cxxx1828/ROS1-Robot-Car-and-Robot-Arm/HW/Proto_Servo_Current_Limiter_Shield/Proto_Servo_Current_Limiter_Shield.kicad_pcb

## KiCad design HW/Proto_Servo_Current_Limiter_Shield/Proto_Servo_Current_Limiter_Shield.kicad_pcb (2025-11-28)

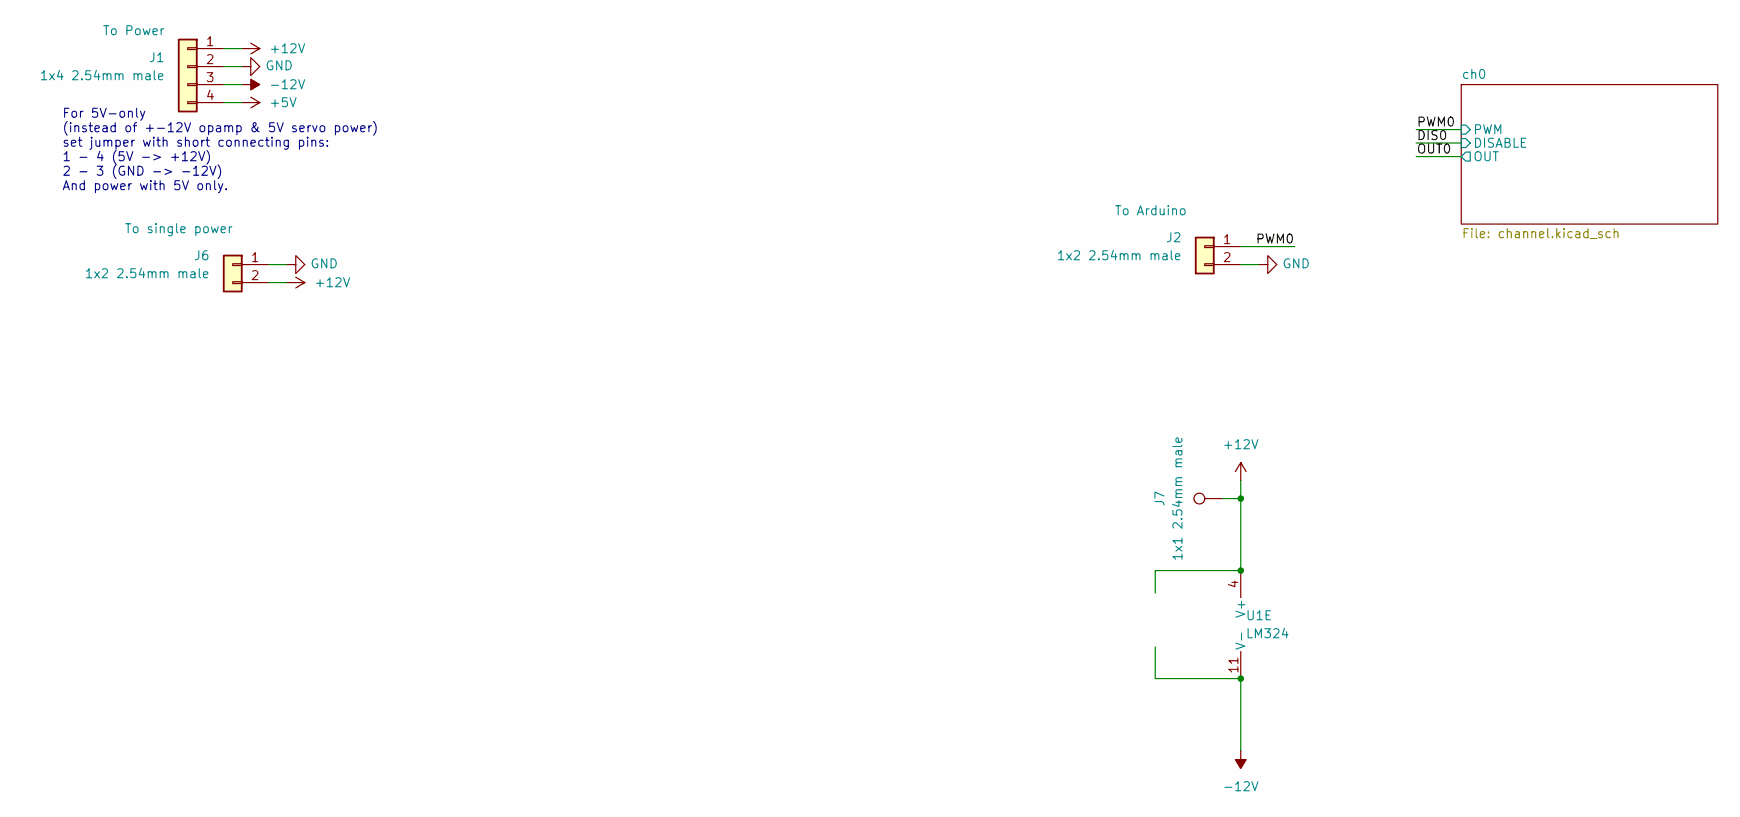
[picture p1: schematic Proto_Servo_Current_Limiter_Shield.kicad_sch]

Parts:
J1: 1x4 2.54mm male; PinHeader_1x04_P2.54mm_Vertical
J2, J6: 1x2 2.54mm male; PinHeader_1x02_P2.54mm_Vertical
J7: 1x1 2.54mm male; PinHeader_1x01_P2.54mm_Vertical
U1: LM324; DIP-14_W7.62mm

Connections:
+5V: J1.4; also elsewhere on the board
+12V: J1.1, J6.2, J7.1, U1.4 (V+); also elsewhere on the board
-12V: J1.3, U1.11 (V-)
/PWM0: J2.1; also elsewhere on the board
GND: J1.2, J2.2, J6.1; also elsewhere on the board

Notes on the sheet:
For 5V-only (instead of +-12V opamp & 5V servo power) set jumper with short connecting pins: 1 - 4 (5V -> +12V) 2 - 3 (GND -> -12V) And power with 5V only.

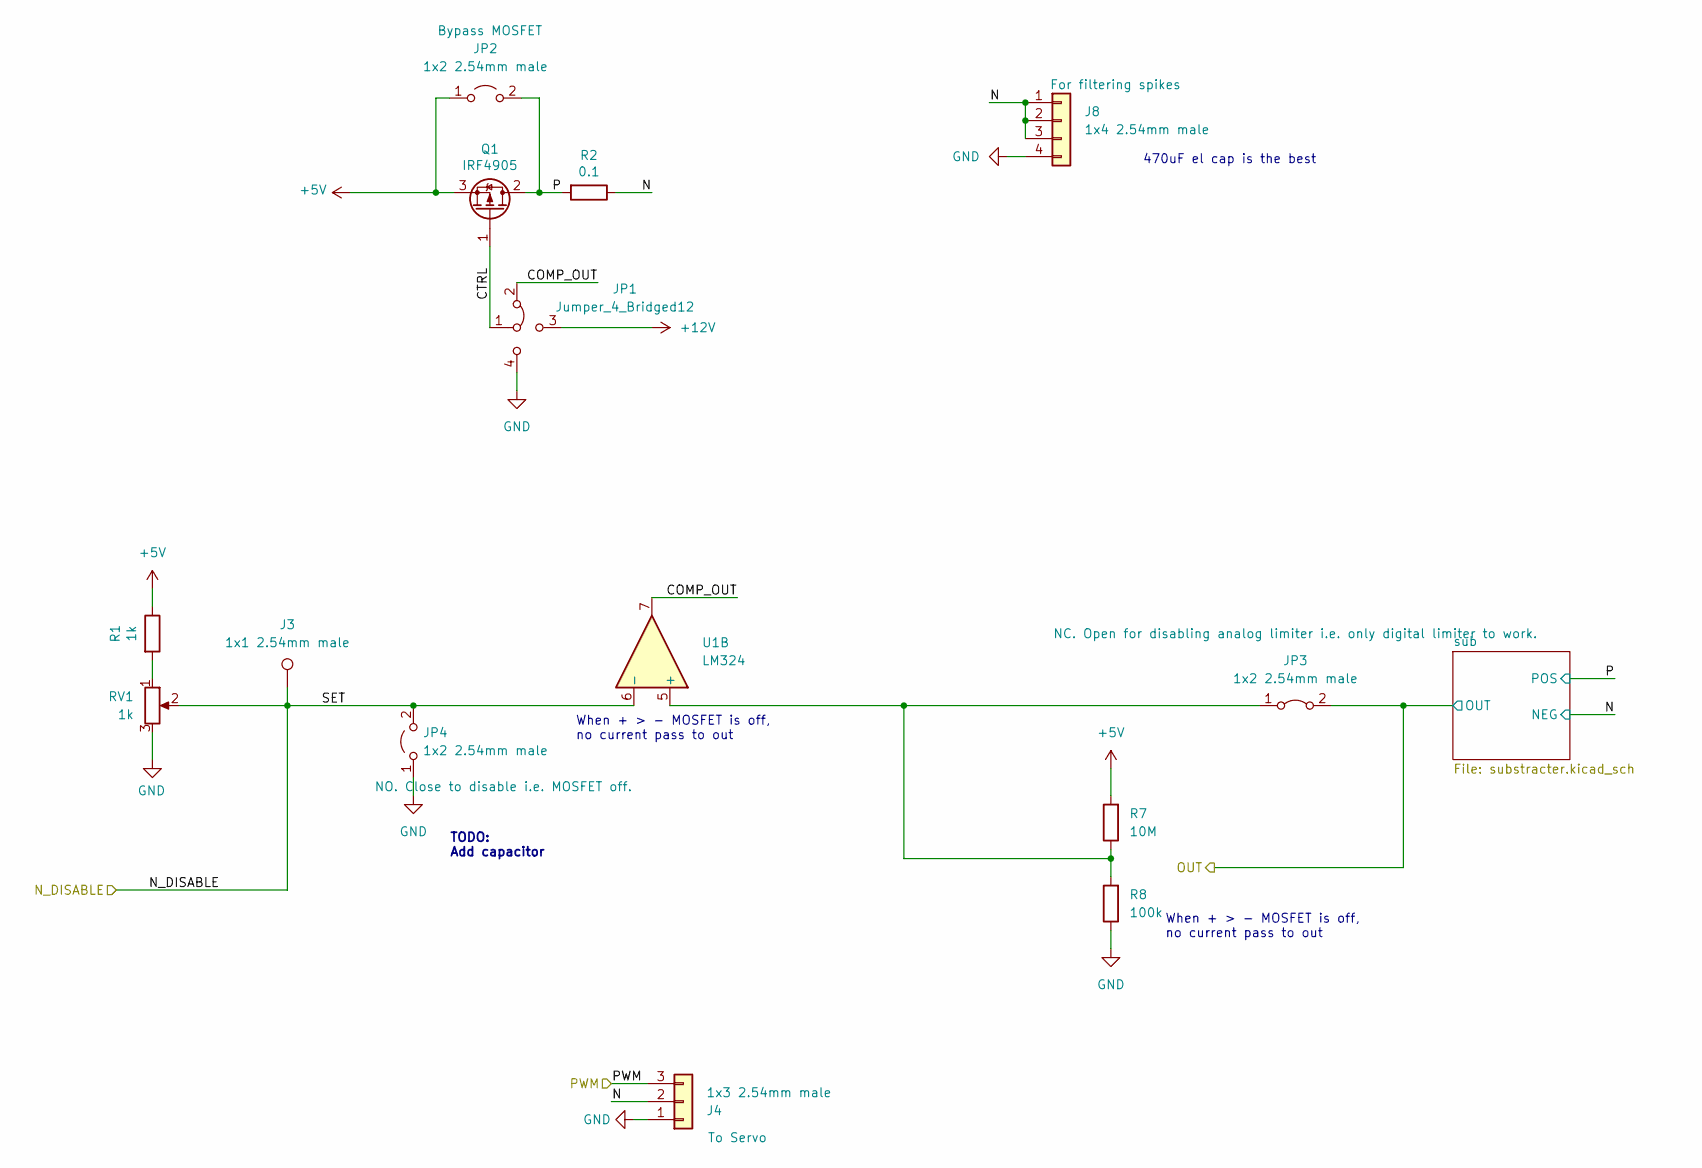
[picture p2: schematic channel.kicad_sch]

Parts:
J3: 1x1 2.54mm male; PinHeader_1x01_P2.54mm_Vertical
J4: 1x3 2.54mm male; PinHeader_1x03_P2.54mm_Vertical
J8: 1x4 2.54mm male; PinHeader_1x04_P2.54mm_Vertical
JP1: Jumper_4_Bridged12; Jumper4_PinHeader_1x04_P2.54mm_Vertical
JP2, JP3, JP4: 1x2 2.54mm male; PinHeader_1x02_P2.54mm_Vertical
Q1: IRF4905; TO-220-3_Vertical
R1: 1k; R_Axial_DIN0207_L6.3mm_D2.5mm_P5.08mm_Vertical
R2: 0.1; R_Axial_DIN0207_L6.3mm_D2.5mm_P7.62mm_Horizontal
R7: 10M; R_Axial_DIN0207_L6.3mm_D2.5mm_P10.16mm_Horizontal
R8: 100k; R_Axial_DIN0207_L6.3mm_D2.5mm_P7.62mm_Horizontal
RV1: 1k; Potentiometer_Piher_PT-10-V10_Vertical
U1: LM324; DIP-14_W7.62mm

Connections:
+5V: JP2.1 (A), Q1.3 (S), R1.1, R7.2; also elsewhere on the board
+12V: JP1.3 (D); also elsewhere on the board
/OUT0: JP3.2 (B); also elsewhere on the board
/PWM0: J4.3; also elsewhere on the board
/ch0/COMP_OUT: JP1.2 (A), U1.7
/ch0/CTRL: JP1.1 (C), Q1.1 (G)
/ch0/N: J4.2, J8.1, J8.2, J8.3, R2.1; also elsewhere on the board
/ch0/N_DISABLE: J3.1, JP4.2 (B), RV1.2, U1.6 (-)
/ch0/P: JP2.2 (B), Q1.2 (D), R2.2; also elsewhere on the board
GND: J4.1, J8.4, JP1.4 (B), JP4.1 (A), R8.1, RV1.3; also elsewhere on the board
unnamed: JP3.1 (A), R7.1, R8.2, U1.5 (+)
unnamed: R1.2, RV1.1

Notes on the sheet:
TODO: Add capacitor
When + > - MOSFET is off, no current pass to out
470uF el cap is the best

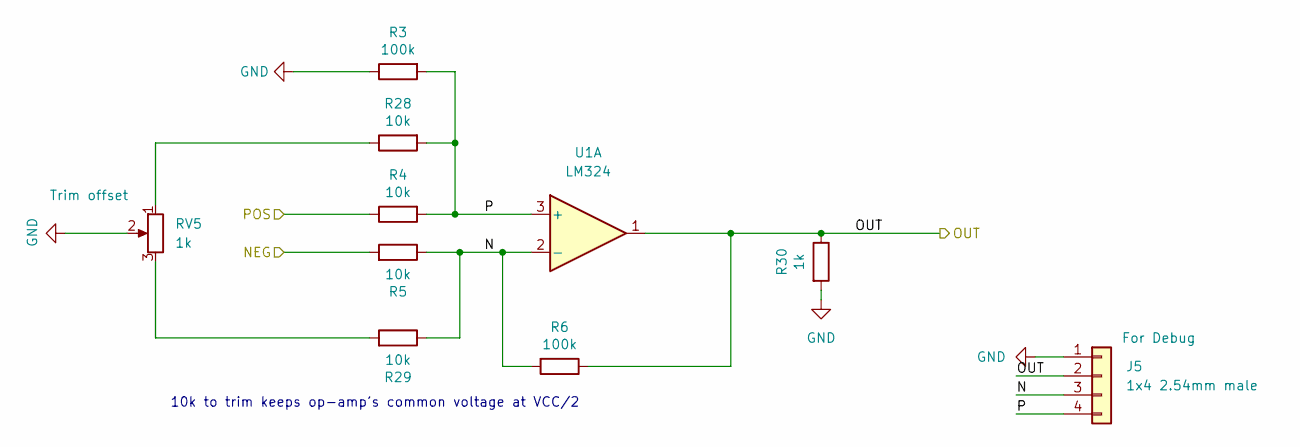
[picture p3: schematic substracter.kicad_sch]

Parts:
J5: 1x4 2.54mm male; PinHeader_1x04_P2.54mm_Vertical
R3: 100k; R_Axial_DIN0207_L6.3mm_D2.5mm_P7.62mm_Horizontal
R4: 10k; R_Axial_DIN0207_L6.3mm_D2.5mm_P12.70mm_Horizontal
R5: 10k; R_Axial_DIN0207_L6.3mm_D2.5mm_P2.54mm_Vertical
R6: 100k; R_Axial_DIN0207_L6.3mm_D2.5mm_P2.54mm_Vertical
R28, R29: 10k; R_Axial_DIN0207_L6.3mm_D2.5mm_Pinf_Vertical
R30: 1k; R_Axial_DIN0207_L6.3mm_D2.5mm_Pinf_Vertical
RV5: 1k; Potentiometer_Piher_PT-10-V10_Vertical
U1: LM324; DIP-14_W7.62mm

Connections:
/OUT0: J5.2, R6.1, R30.1, U1.1; also elsewhere on the board
/ch0/N: R5.2; also elsewhere on the board
/ch0/P: R4.1; also elsewhere on the board
/ch0/sub/N: J5.3, R5.1, R6.2, R29.1, U1.2 (-)
/ch0/sub/P: J5.4, R3.2, R4.2, R28.2, U1.3 (+)
GND: J5.1, R3.1, R30.2, RV5.2; also elsewhere on the board
unnamed: R28.1, RV5.1
unnamed: R29.2, RV5.3

Notes on the sheet:
10k to trim keeps op-amp's common voltage at VCC/2

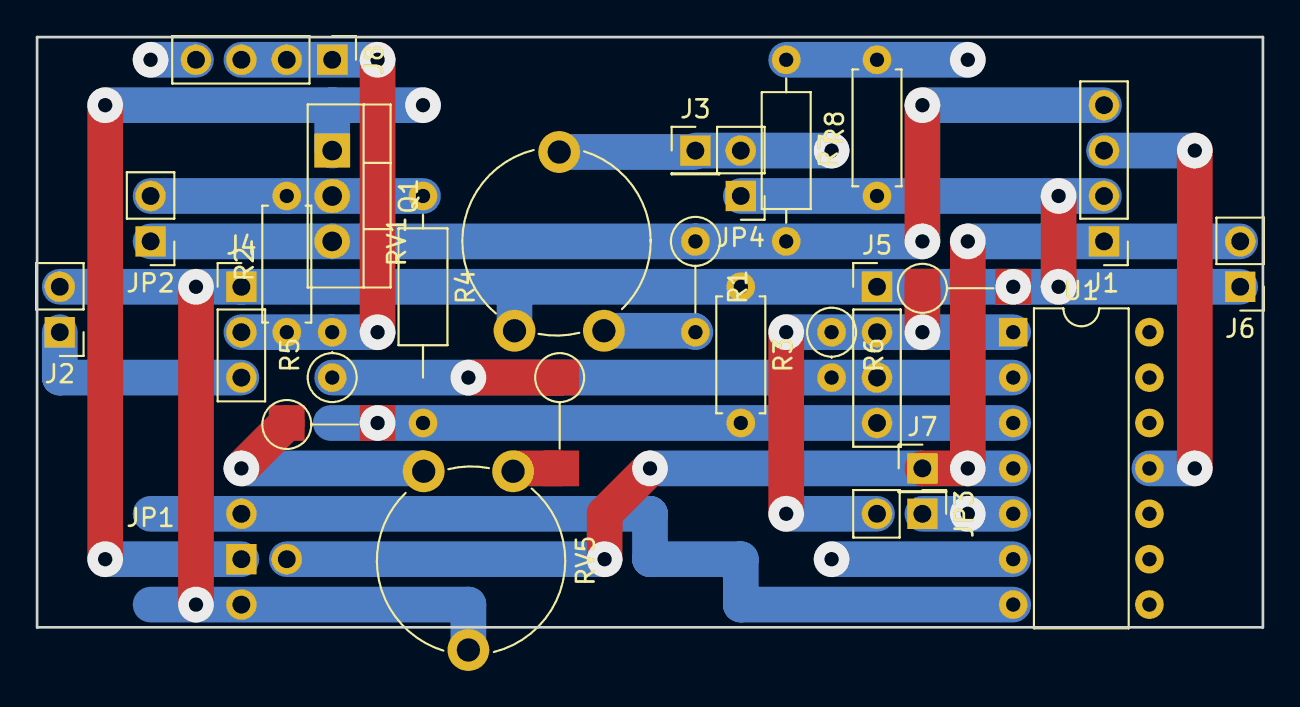
[picture p4: board Proto_Servo_Current_Limiter_Shield.kicad_pcb from above]

Board: 2 copper layers, 68.6 x 33.0 mm, 27 parts (0 on the bottom side), 17 nets.
