cxxx1828/ROS1-Robot-Car-and-Robot-Arm/HW/Servo_Motor_Shield_v1/Servo_Motor_Shield_v1.kicad_pcb

## KiCad design HW/Servo_Motor_Shield_v1/Servo_Motor_Shield_v1.kicad_pcb (2025-11-28)

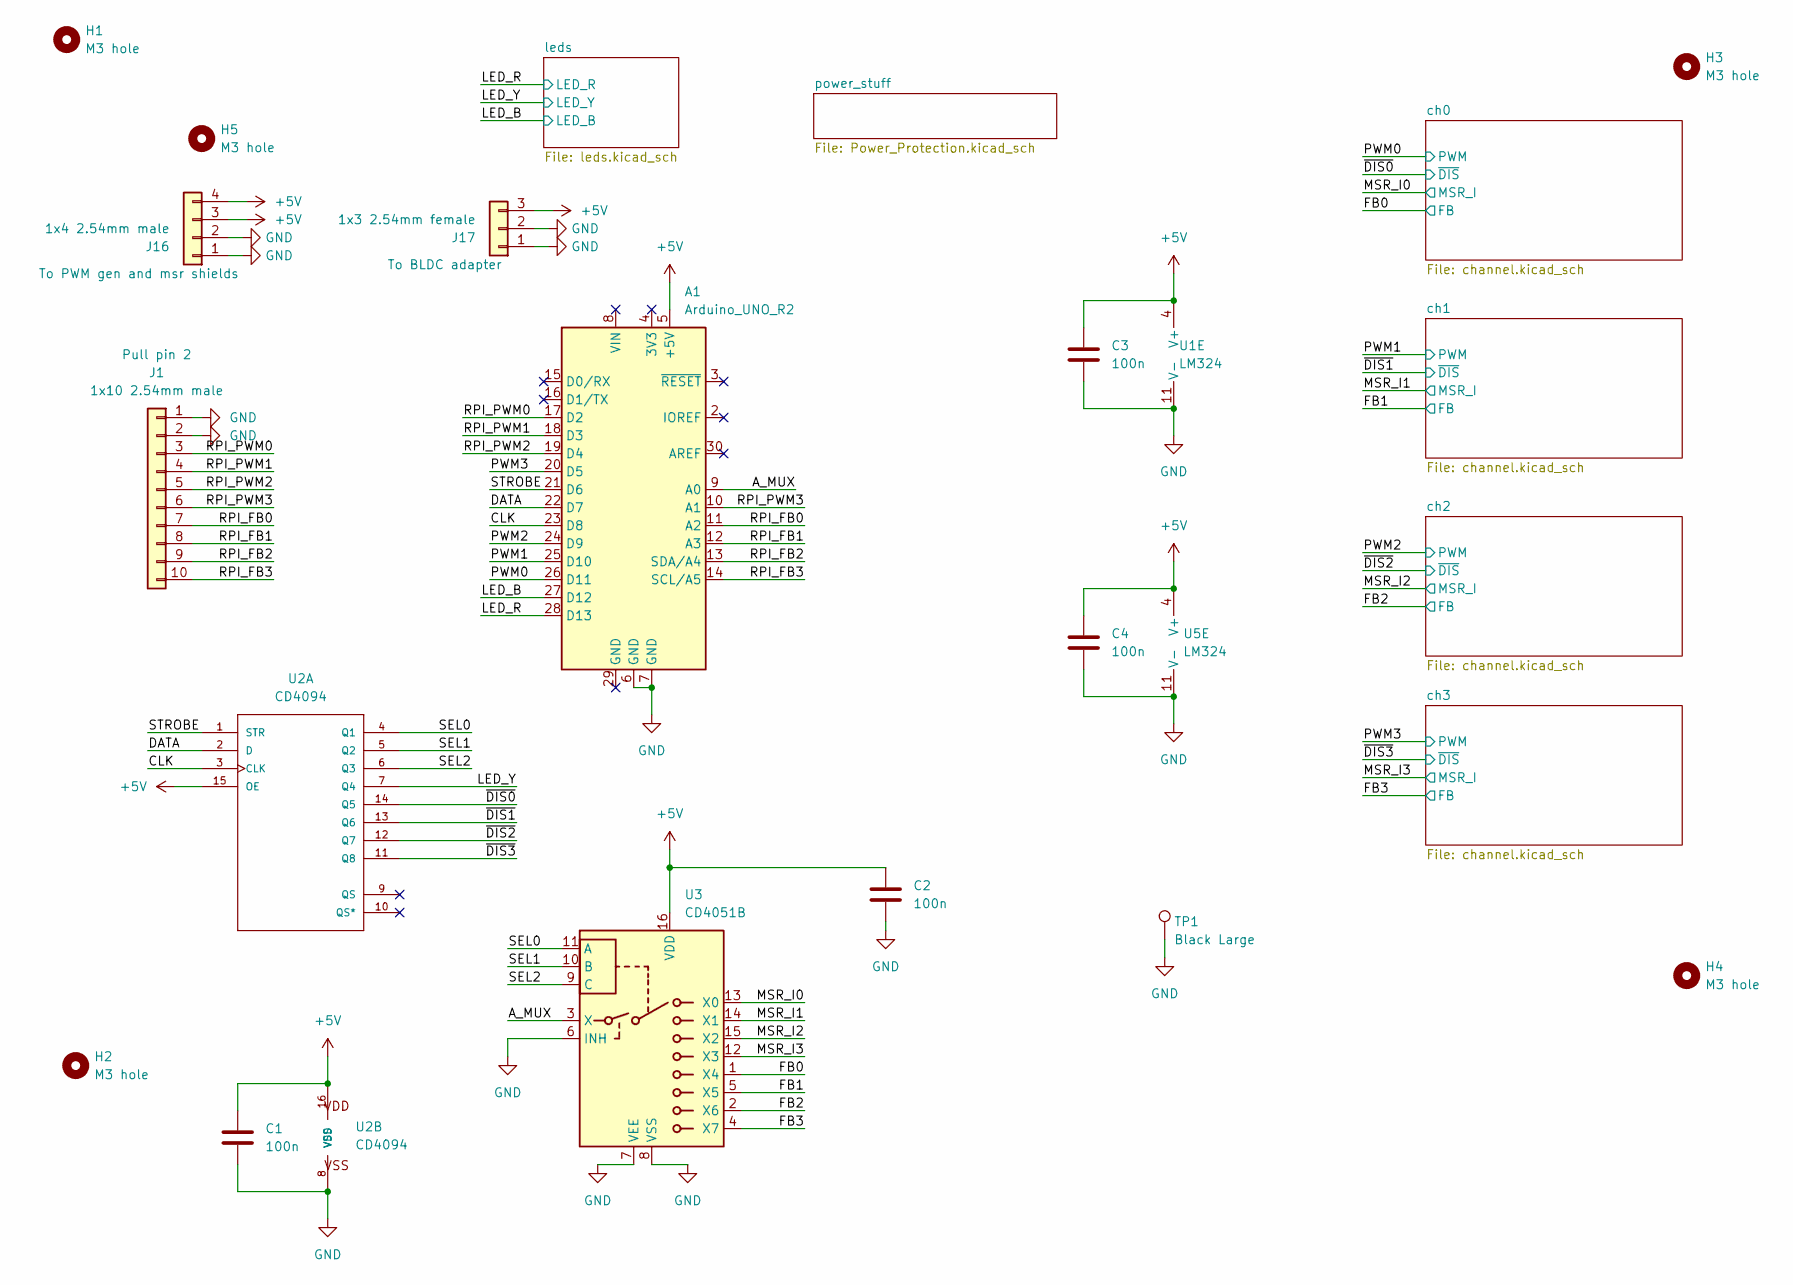
[picture p5: schematic Servo_Motor_Shield_v1.kicad_sch]

Parts:
A1: Arduino_UNO_R2; Arduino_UNO_R3_WithMountingHoles_Snapped_to_P2.54mm_Custom_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
C1, C2: 100n; C_Disc_D3.0mm_W1.6mm_P2.50mm
C3, C4: 100n; C_1206_3216Metric
H1, H2, H3, H4, H5: M3 hole; MountingHole_3.2mm_M3
J1: 1x10 2.54mm male; PinHeader_1x10_P2.54mm_Vertical
J16: 1x4 2.54mm male; PinHeader_1x04_P2.54mm_Vertical
J17: 1x3 2.54mm female; PinSocket_1x03_P2.54mm_Vertical
TP1: Black Large; TestPoint_THTPad_D2.0mm_Drill1.0mm
U1, U5: LM324; DIP-14_W7.62mm
U2: CD4094; DIP-16_W7.62mm
U3: CD4051B; DIP-16_W7.62mm

Connections:
+5V: A1.5 (+5V), C1.1, C2.1, C3.1, C4.1, J16.3, J16.4, J17.3, U1.4 (V+), U2.15 (OE), U2.16 (VDD), U3.16 (VDD), U5.4 (V+); also elsewhere on the board
/A_MUX: A1.9 (A0), U3.3 (X)
/CLK: A1.23 (D8), U2.3 (CLK)
/DATA: A1.22 (D7), U2.2 (D)
/FB0: U3.1 (X4); also elsewhere on the board
/FB1: U3.5 (X5); also elsewhere on the board
/FB2: U3.2 (X6); also elsewhere on the board
/FB3: U3.4 (X7); also elsewhere on the board
/LED_B: A1.27 (D12); also elsewhere on the board
/LED_R: A1.28 (D13); also elsewhere on the board
/LED_Y: U2.7 (Q4); also elsewhere on the board
/MSR_I0: U3.13 (X0); also elsewhere on the board
/MSR_I1: U1.8, U3.14 (X1); also elsewhere on the board
/MSR_I2: U3.15 (X2); also elsewhere on the board
/MSR_I3: U3.12 (X3), U5.8; also elsewhere on the board
/PWM0: A1.26 (D11); also elsewhere on the board
/PWM1: A1.25 (D10); also elsewhere on the board
/PWM2: A1.24 (D9); also elsewhere on the board
/PWM3: A1.20 (D5); also elsewhere on the board
/RPI_FB0: A1.11 (A2), J1.7
/RPI_FB1: A1.12 (A3), J1.8
/RPI_FB2: A1.13 (SDA/A4), J1.9
/RPI_FB3: A1.14 (SCL/A5), J1.10
/RPI_PWM0: A1.17 (D2), J1.3
/RPI_PWM1: A1.18 (D3), J1.4
/RPI_PWM2: A1.19 (D4), J1.5
/RPI_PWM3: A1.10 (A1), J1.6
/SEL0: U2.4 (Q1), U3.11 (A)
/SEL1: U2.5 (Q2), U3.10 (B)
/SEL2: U2.6 (Q3), U3.9 (C)
/STROBE: A1.21 (D6), U2.1 (STR)
/ch1/CTRL: U1.7; also elsewhere on the board
/ch1/sub/N_SUB: U1.9 (-); also elsewhere on the board
/ch1/sub/P_SUB: U1.10 (+); also elsewhere on the board
/ch3/CTRL: U5.7; also elsewhere on the board
/ch3/sub/N_SUB: U5.9 (-); also elsewhere on the board
/ch3/sub/P_SUB: U5.10 (+); also elsewhere on the board
/~DIS0: U2.14 (Q5); also elsewhere on the board
/~DIS1: U1.6 (-), U2.13 (Q6); also elsewhere on the board
/~DIS2: U2.12 (Q7); also elsewhere on the board
/~DIS3: U2.11 (Q8), U5.6 (-); also elsewhere on the board
GND: A1.6 (GND), A1.7 (GND), C1.2, C2.2, C3.2, C4.2, J1.1, J1.2, J16.1, J16.2, J17.1, J17.2, TP1.1, U1.11 (V-), U2.8 (VSS), U3.6 (INH), U3.7 (VEE), U3.8 (VSS), U5.11 (V-); also elsewhere on the board
unnamed 72: U1.5 (+); also elsewhere on the board
unnamed 74: U5.5 (+); also elsewhere on the board

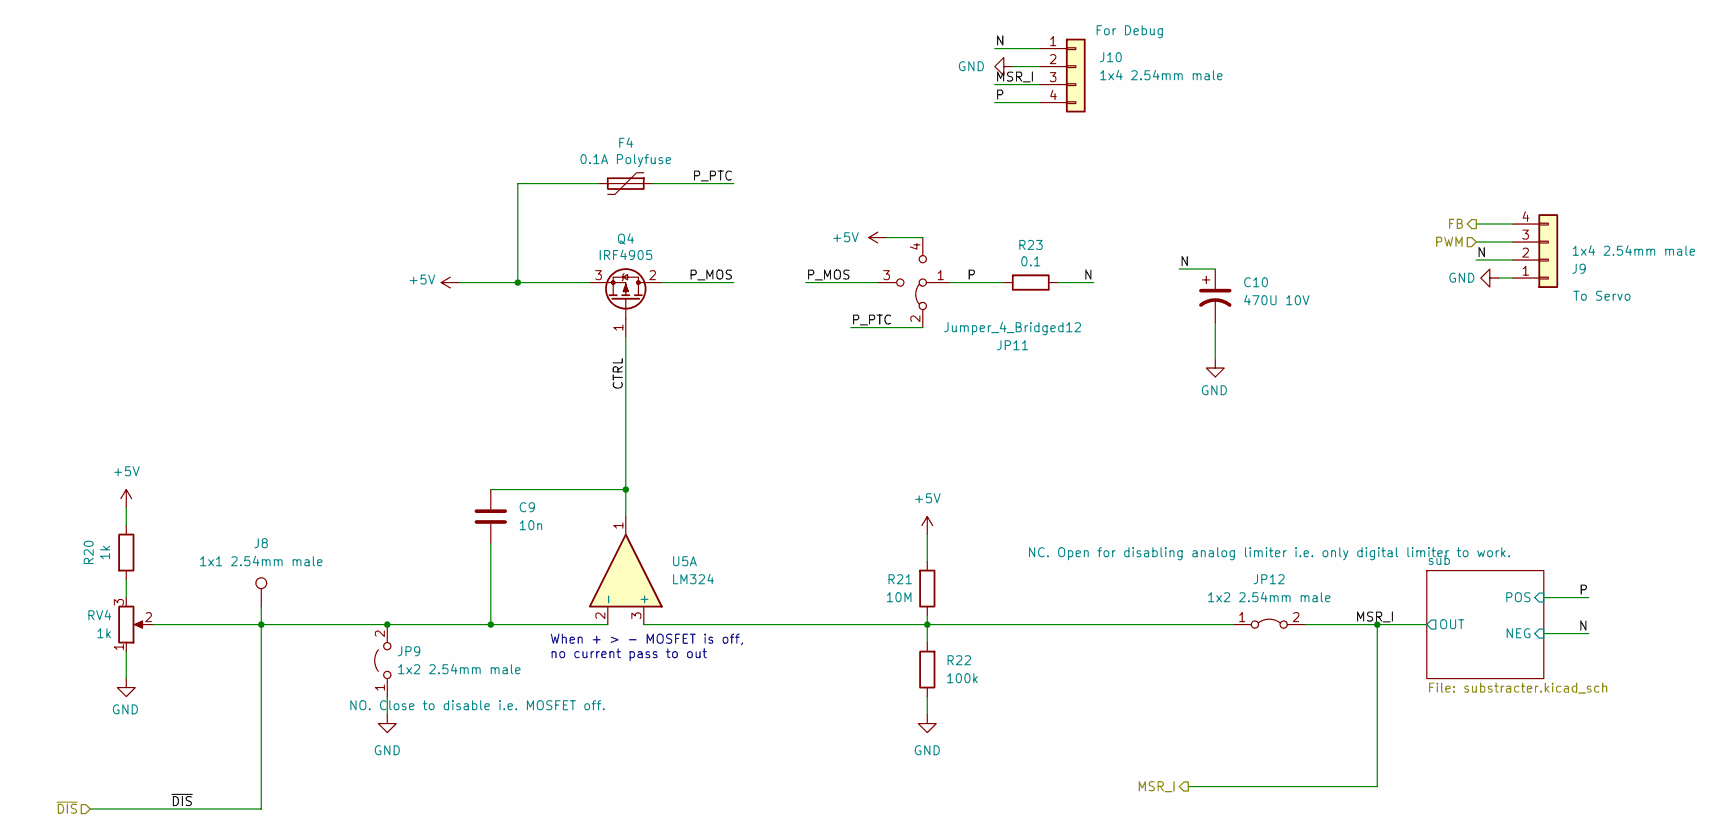
[picture p6: schematic channel.kicad_sch]

Parts:
C9: 10n; C_Disc_D3.0mm_W1.6mm_P2.50mm
C10: 470U 10V; CP_Radial_D10.0mm_P2.50mm
F4: 0.1A Polyfuse; C_Disc_D3.0mm_W1.6mm_P5.00mm
J8: 1x1 2.54mm male; PinHeader_1x01_P2.54mm_Vertical
J9, J10: 1x4 2.54mm male; PinHeader_1x04_P2.54mm_Vertical
JP9, JP12: 1x2 2.54mm male; PinHeader_1x02_P2.54mm_Vertical
JP11: Jumper_4_Bridged12; Jumper4_PinHeader_1x04_P2.54mm_Vertical
Q4: IRF4905; TO-220-3_Vertical
R20: 1k; R_Axial_DIN0207_L6.3mm_D2.5mm_P12.70mm_Horizontal
R21: 10M; R_Axial_DIN0207_L6.3mm_D2.5mm_P2.54mm_Vertical
R22: 100k; R_Axial_DIN0207_L6.3mm_D2.5mm_P7.62mm_Horizontal
R23: 0.1; R_Axial_DIN0207_L6.3mm_D2.5mm_P7.62mm_Horizontal
RV4: 1k; Potentiometer_Piher_PT-10-V10_Vertical
U5: LM324; DIP-14_W7.62mm

Connections:
+5V: F4.2, JP11.4 (B), Q4.3 (S), R20.1, R21.2; also elsewhere on the board
/FB2: J9.4; also elsewhere on the board
/MSR_I2: J10.3, JP12.2 (B); also elsewhere on the board
/MSR_I3: U5.8; also elsewhere on the board
/PWM2: J9.3; also elsewhere on the board
/ch2/CTRL: C9.1, Q4.1 (G), U5.1
/ch2/N: C10.1, J9.2, J10.1, R23.1; also elsewhere on the board
/ch2/P: J10.4, JP11.1 (C), R23.2; also elsewhere on the board
/ch2/P_MOS: JP11.3 (D), Q4.2 (D)
/ch2/P_PTC: F4.1, JP11.2 (A)
/ch3/CTRL: U5.7; also elsewhere on the board
/ch3/sub/N_SUB: U5.9 (-); also elsewhere on the board
/ch3/sub/P_SUB: U5.10 (+); also elsewhere on the board
/~DIS2: C9.2, J8.1, JP9.2 (B), RV4.2, U5.2 (-); also elsewhere on the board
/~DIS3: U5.6 (-); also elsewhere on the board
GND: C10.2, J9.1, J10.2, JP9.1 (A), R22.1, RV4.1; also elsewhere on the board
unnamed: JP12.1 (A), R21.1, R22.2, U5.3 (+)
unnamed 74: U5.5 (+); also elsewhere on the board
unnamed: R20.2, RV4.3

Parts of its further copies:
C5, C7, C11: 10n; C_Disc_D3.0mm_W1.6mm_P2.50mm
C6, C8, C12: 470U 10V; CP_Radial_D10.0mm_P2.50mm
F2, F3, F5: 0.1A Polyfuse; C_Disc_D3.0mm_W1.6mm_P5.00mm
J2, J3, J11: 1x1 2.54mm male; PinHeader_1x01_P2.54mm_Vertical
J4, J5, J6, J7, J12, J13: 1x4 2.54mm male; PinHeader_1x04_P2.54mm_Vertical
JP2, JP7, JP15: Jumper_4_Bridged12; Jumper4_PinHeader_1x04_P2.54mm_Vertical
JP3, JP4, JP5, JP8, JP13, JP16: 1x2 2.54mm male; PinHeader_1x02_P2.54mm_Vertical
Q1, Q2, Q5: IRF4905; TO-220-3_Vertical
R1, R9, R34: 1k; R_Axial_DIN0207_L6.3mm_D2.5mm_P12.70mm_Horizontal
R2, R12, R37: 0.1; R_Axial_DIN0207_L6.3mm_D2.5mm_P7.62mm_Horizontal
R7, R10, R35: 10M; R_Axial_DIN0207_L6.3mm_D2.5mm_P2.54mm_Vertical
R8, R11, R36: 100k; R_Axial_DIN0207_L6.3mm_D2.5mm_P7.62mm_Horizontal
RV1, RV2, RV7: 1k; Potentiometer_Piher_PT-10-V10_Vertical

Connections of its further copies:
+5V: F2.2, F3.2, F5.2, JP2.4 (B), JP7.4 (B), JP15.4 (B), Q1.3 (S), Q2.3 (S), Q5.3 (S), R1.1, R7.2, R9.1, R10.2, R34.1, R35.2; also elsewhere on the board
/FB0: J4.4; also elsewhere on the board
/FB1: J6.4; also elsewhere on the board
/FB3: J12.4; also elsewhere on the board
/MSR_I0: J5.3, JP3.2 (B); also elsewhere on the board
/MSR_I1: J7.3, JP8.2 (B); also elsewhere on the board
/MSR_I3: J13.3, JP16.2 (B); also elsewhere on the board
/PWM0: J4.3; also elsewhere on the board
/PWM1: J6.3; also elsewhere on the board
/PWM3: J12.3; also elsewhere on the board
/ch0/CTRL: C5.1, Q1.1 (G); also elsewhere on the board
/ch0/N: C6.1, J4.2, J5.1, R2.1; also elsewhere on the board
/ch0/P: J5.4, JP2.1 (C), R2.2; also elsewhere on the board
/ch0/P_MOS: JP2.3 (D), Q1.2 (D)
/ch0/P_PTC: F2.1, JP2.2 (A)
/ch1/CTRL: C7.1, Q2.1 (G); also elsewhere on the board
/ch1/N: C8.1, J6.2, J7.1, R12.1; also elsewhere on the board
/ch1/P: J7.4, JP7.1 (C), R12.2; also elsewhere on the board
/ch1/P_MOS: JP7.3 (D), Q2.2 (D)
/ch1/P_PTC: F3.1, JP7.2 (A)
/ch3/CTRL: C11.1, Q5.1 (G); also elsewhere on the board
/ch3/N: C12.1, J12.2, J13.1, R37.1; also elsewhere on the board
/ch3/P: J13.4, JP15.1 (C), R37.2; also elsewhere on the board
/ch3/P_MOS: JP15.3 (D), Q5.2 (D)
/ch3/P_PTC: F5.1, JP15.2 (A)
/~DIS0: C5.2, J3.1, JP4.2 (B), RV1.2; also elsewhere on the board
/~DIS1: C7.2, J2.1, JP5.2 (B), RV2.2; also elsewhere on the board
/~DIS3: C11.2, J11.1, JP13.2 (B), RV7.2; also elsewhere on the board
GND: C6.2, C8.2, C12.2, J4.1, J5.2, J6.1, J7.2, J12.1, J13.2, JP4.1 (A), JP5.1 (A), JP13.1 (A), R8.1, R11.1, R36.1, RV1.1, RV2.1, RV7.1; also elsewhere on the board
unnamed 71: JP3.1 (A), R7.1, R8.2; also elsewhere on the board
unnamed 72: JP8.1 (A), R10.1, R11.2; also elsewhere on the board
unnamed 74: JP16.1 (A), R35.1, R36.2; also elsewhere on the board
unnamed: R1.2, RV1.3
unnamed: R9.2, RV2.3
unnamed: R34.2, RV7.3

Notes on the sheet:
When + > - MOSFET is off, no current pass to out

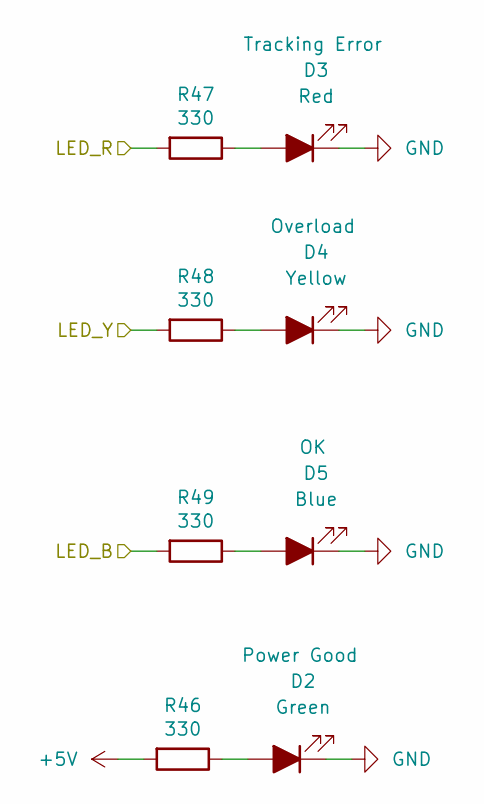
[picture p7: schematic leds.kicad_sch]

Parts:
D2: Green; LED_D3.0mm
D3: Red; LED_D3.0mm
D4: Yellow; LED_D3.0mm
D5: Blue; LED_D3.0mm
R46: 330; R_Axial_DIN0207_L6.3mm_D2.5mm_P2.54mm_Vertical
R47, R49: 330; R_Axial_DIN0207_L6.3mm_D2.5mm_P7.62mm_Horizontal
R48: 330; R_Axial_DIN0207_L6.3mm_D2.5mm_P5.08mm_Vertical

Connections:
+5V: R46.2; also elsewhere on the board
/LED_B: R49.2; also elsewhere on the board
/LED_R: R47.2; also elsewhere on the board
/LED_Y: R48.2; also elsewhere on the board
GND: D2.1 (K), D3.1 (K), D4.1 (K), D5.1 (K); also elsewhere on the board
unnamed: D2.2 (A), R46.1
unnamed: D3.2 (A), R47.1
unnamed: D4.2 (A), R48.1
unnamed: D5.2 (A), R49.1

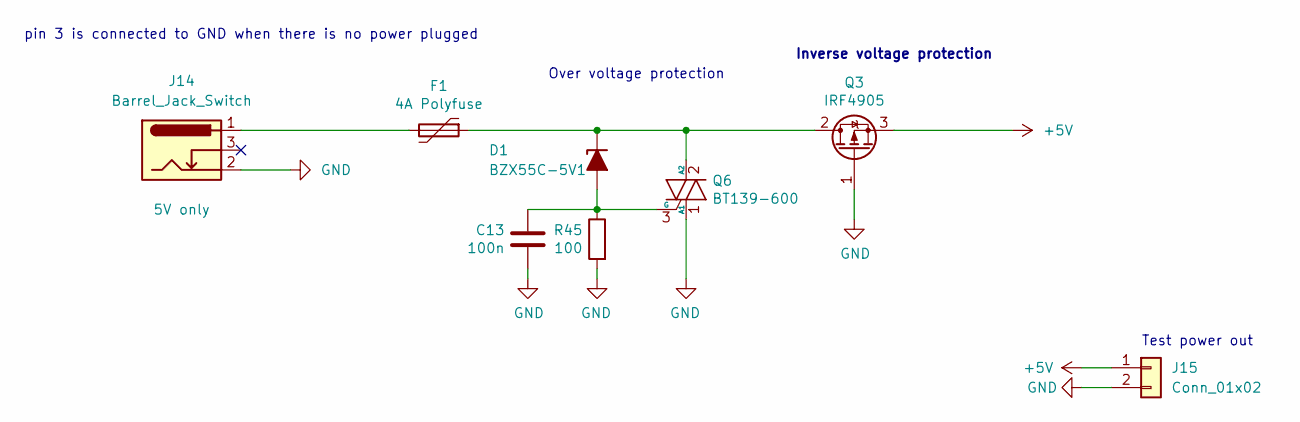
[picture p8: schematic Power_Protection.kicad_sch]

Parts:
C13: 100n; C_Disc_D3.0mm_W1.6mm_P5.00mm
D1: BZX55C-5V1; D_DO-35_SOD27_P2.54mm_Vertical_KathodeUp
F1: 4A Polyfuse; C_Disc_D3.0mm_W1.6mm_P5.00mm
J14: Barrel_Jack_Switch; BarrelJack_Horizontal
J15: Conn_01x02; PinHeader_1x02_P2.54mm_Vertical
Q3: IRF4905; TO-220-3_Vertical
Q6: BT139-600; TO-220-3_Vertical
R45: 100; R_Axial_DIN0207_L6.3mm_D2.5mm_P10.16mm_Horizontal

Connections:
+5V: J15.1, Q3.3 (S); also elsewhere on the board
GND: C13.1, J14.2, J15.2, Q3.1 (G), Q6.1 (A1), R45.2; also elsewhere on the board
unnamed: C13.2, D1.2 (A), Q6.3 (G), R45.1
unnamed: D1.1 (K), F1.1, Q3.2 (D), Q6.2 (A2)
unnamed: F1.2, J14.1

Notes on the sheet:
Inverse voltage protection
pin 3 is connected to GND when there is no power plugged
Test power out
Over voltage protection

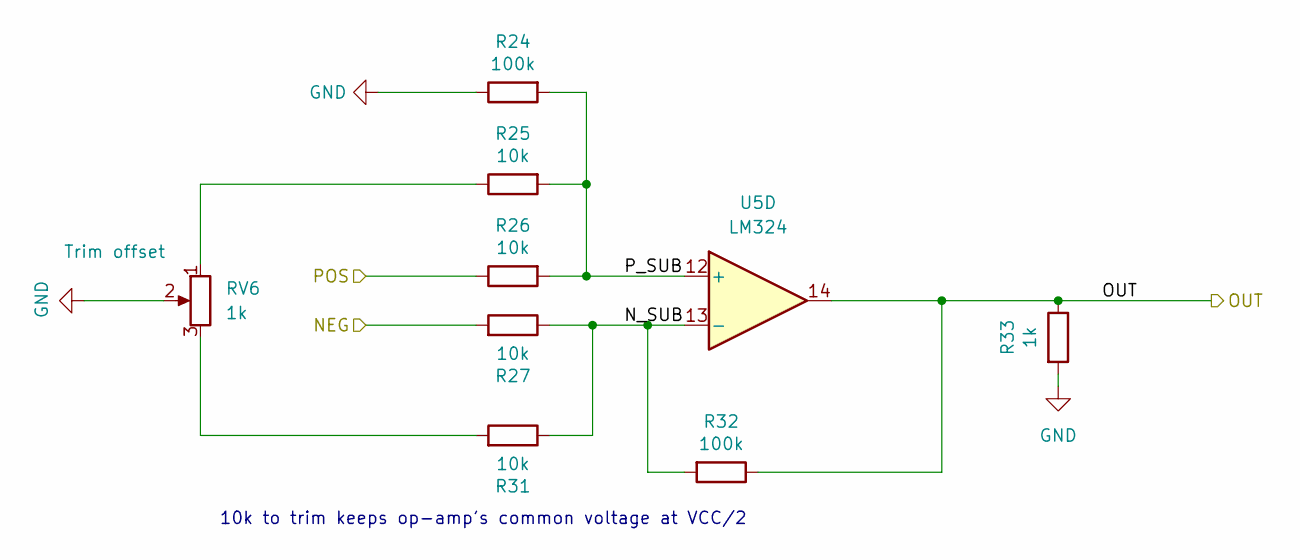
[picture p9: schematic substracter.kicad_sch]

Parts:
R24: 100k; R_Axial_DIN0207_L6.3mm_D2.5mm_P7.62mm_Horizontal
R25: 10k; R_Axial_DIN0207_L6.3mm_D2.5mm_P17.78mm_Horizontal
R26: 10k; R_Axial_DIN0207_L6.3mm_D2.5mm_P2.54mm_Vertical
R27: 10k; R_Axial_DIN0207_L6.3mm_D2.5mm_P7.62mm_Horizontal
R31: 10k; R_Axial_DIN0207_L6.3mm_D2.5mm_P15.24mm_Horizontal
R32: 100k; R_Axial_DIN0207_L6.3mm_D2.5mm_P2.54mm_Vertical
R33: 1k; R_Axial_DIN0207_L6.3mm_D2.5mm_P2.54mm_Vertical
RV6: 1k; Potentiometer_Piher_PT-10-V10_Vertical
U5: LM324; DIP-14_W7.62mm

Connections:
/MSR_I2: R32.1, R33.1, U5.14; also elsewhere on the board
/MSR_I3: U5.8; also elsewhere on the board
/ch2/N: R27.2; also elsewhere on the board
/ch2/P: R26.1; also elsewhere on the board
/ch2/sub/N_SUB: R27.1, R31.1, R32.2, U5.13 (-)
/ch2/sub/P_SUB: R24.2, R25.2, R26.2, U5.12 (+)
/ch3/CTRL: U5.7; also elsewhere on the board
/ch3/sub/N_SUB: U5.9 (-); also elsewhere on the board
/ch3/sub/P_SUB: U5.10 (+); also elsewhere on the board
/~DIS3: U5.6 (-); also elsewhere on the board
GND: R24.1, R33.2, RV6.2; also elsewhere on the board
unnamed 74: U5.5 (+); also elsewhere on the board
unnamed: R25.1, RV6.1
unnamed: R31.2, RV6.3

Parts of its further copies:
R3, R13, R38: 100k; R_Axial_DIN0207_L6.3mm_D2.5mm_P7.62mm_Horizontal
R4, R15, R40: 10k; R_Axial_DIN0207_L6.3mm_D2.5mm_P2.54mm_Vertical
R5, R16, R41: 10k; R_Axial_DIN0207_L6.3mm_D2.5mm_P7.62mm_Horizontal
R6, R18, R43: 100k; R_Axial_DIN0207_L6.3mm_D2.5mm_P2.54mm_Vertical
R14, R28, R39: 10k; R_Axial_DIN0207_L6.3mm_D2.5mm_P17.78mm_Horizontal
R17, R29, R42: 10k; R_Axial_DIN0207_L6.3mm_D2.5mm_P15.24mm_Horizontal
R19, R30, R44: 1k; R_Axial_DIN0207_L6.3mm_D2.5mm_P2.54mm_Vertical
RV3, RV5, RV8: 1k; Potentiometer_Piher_PT-10-V10_Vertical

Connections of its further copies:
/MSR_I0: R6.1, R30.1; also elsewhere on the board
/MSR_I1: R18.1, R19.1; also elsewhere on the board
/MSR_I3: R43.1, R44.1; also elsewhere on the board
/ch0/N: R5.2; also elsewhere on the board
/ch0/P: R4.1; also elsewhere on the board
/ch0/sub/N_SUB: R5.1, R6.2, R29.1; also elsewhere on the board
/ch0/sub/P_SUB: R3.2, R4.2, R28.2; also elsewhere on the board
/ch1/N: R16.2; also elsewhere on the board
/ch1/P: R15.1; also elsewhere on the board
/ch1/sub/N_SUB: R16.1, R17.1, R18.2; also elsewhere on the board
/ch1/sub/P_SUB: R13.2, R14.2, R15.2; also elsewhere on the board
/ch3/N: R41.2; also elsewhere on the board
/ch3/P: R40.1; also elsewhere on the board
/ch3/sub/N_SUB: R41.1, R42.1, R43.2; also elsewhere on the board
/ch3/sub/P_SUB: R38.2, R39.2, R40.2; also elsewhere on the board
GND: R3.1, R13.1, R19.2, R30.2, R38.1, R44.2, RV3.2, RV5.2, RV8.2; also elsewhere on the board
unnamed: R14.1, RV3.1
unnamed: R17.2, RV3.3
unnamed: R28.1, RV5.1
unnamed: R29.2, RV5.3
unnamed: R39.1, RV8.1
unnamed: R42.2, RV8.3

Notes on the sheet:
10k to trim keeps op-amp's common voltage at VCC/2

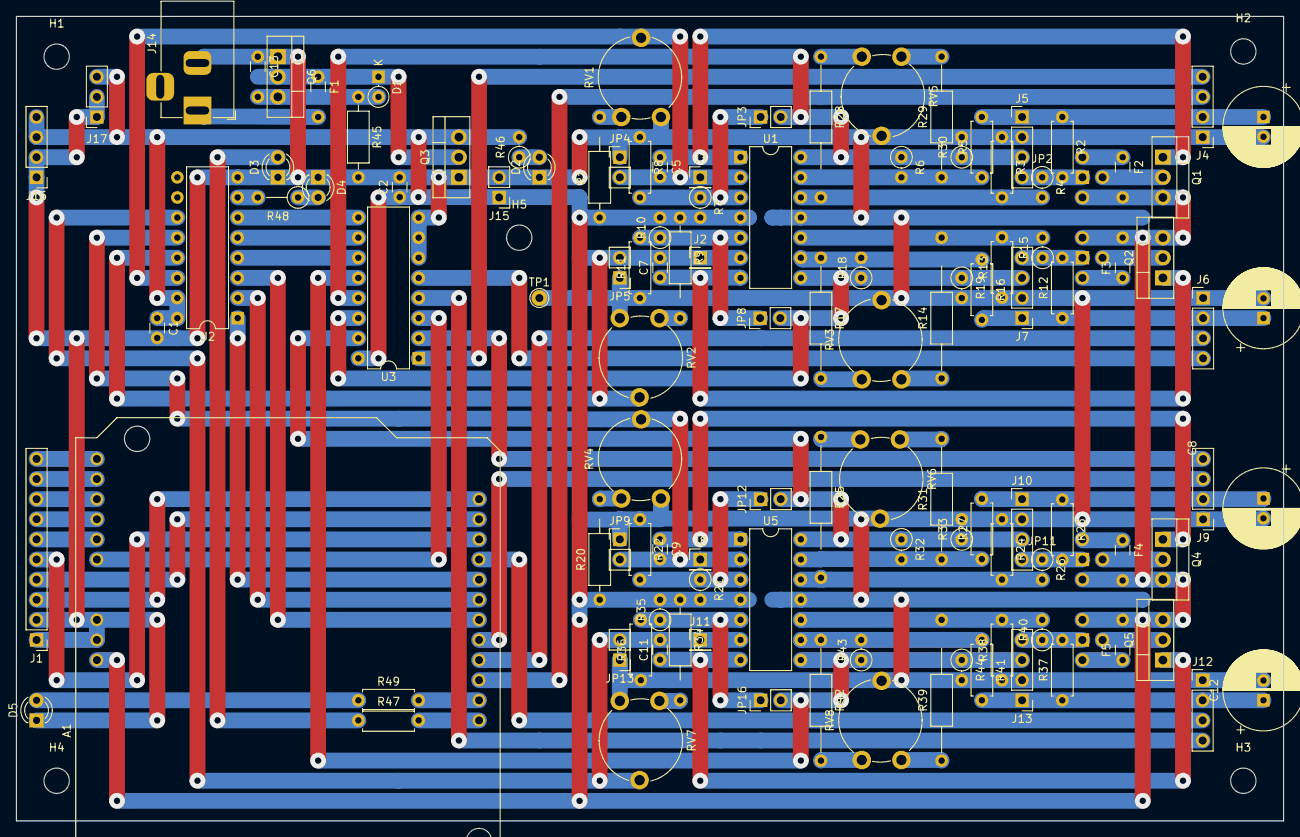
[picture p10: board Servo_Motor_Shield_v1.kicad_pcb from above]

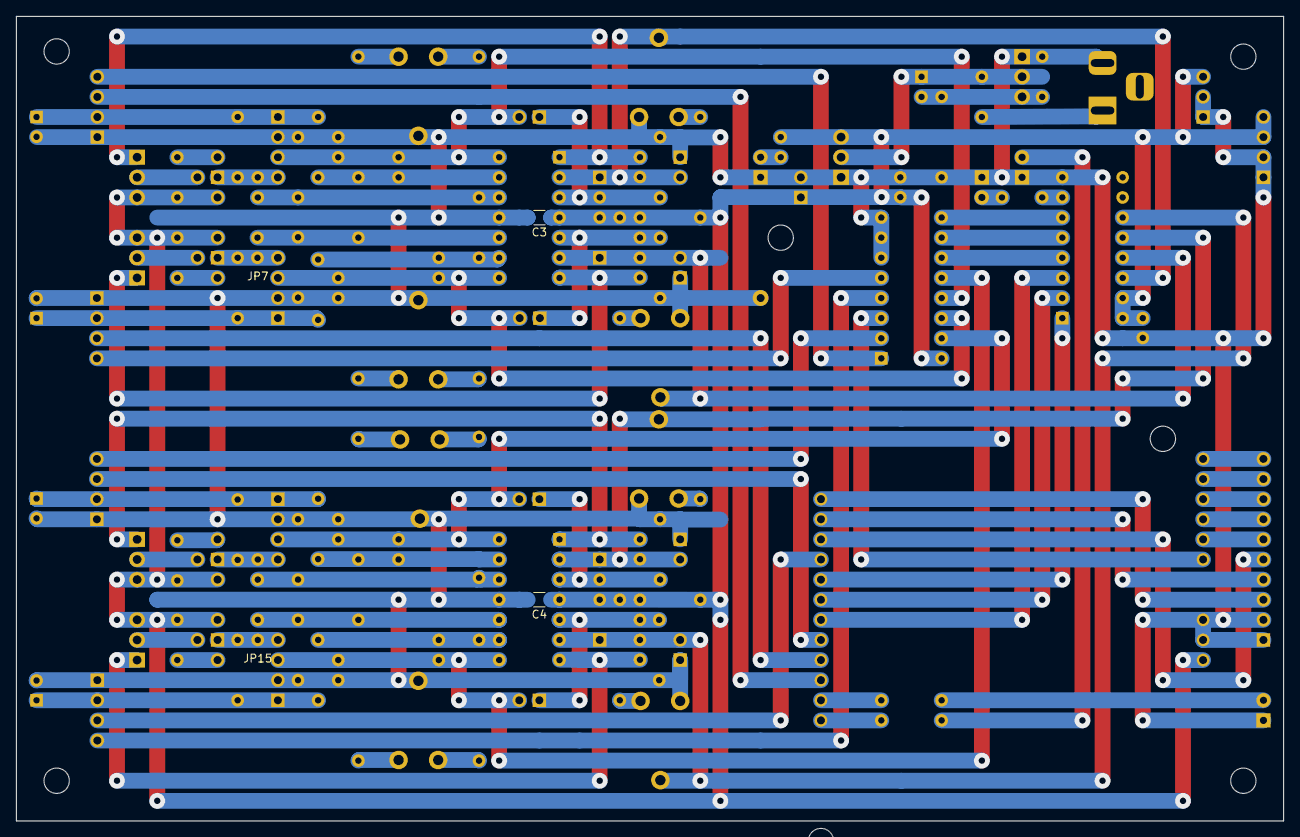
[picture p11: board Servo_Motor_Shield_v1.kicad_pcb from below]

Board: 2 copper layers, 160.0 x 101.6 mm, 126 parts (4 on the bottom side), 87 nets.
