cxxx1828/ROS1-Robot-Car-and-Robot-Arm/ROS/arm_and_chassis_ws/src/s3a_moveit_config/config/joint_limits.yaml

# joint_limits.yaml allows the dynamics properties specified in the URDF to be overwritten or augmented as needed

# For beginners, we downscale velocity and acceleration limits.
# You can always specify higher scaling factors (<= 1.0) in your motion requests.  # Increase the values below to 1.0 to always move at maximum speed.
default_velocity_scaling_factor: 1.0
default_acceleration_scaling_factor: 1.0

# Specific joint properties can be changed with the keys [max_position, min_position, max_velocity, max_acceleration]
# Joint limits can be turned off with [has_velocity_limits, has_acceleration_limits]
joint_limits:
  joint0_shoulder_pan:
    has_velocity_limits: true
    max_velocity: 62.8
    has_acceleration_limits: true
    max_acceleration: 7.85
  joint1_shoulder_lift:
    has_velocity_limits: true
    max_velocity: 62.8
    has_acceleration_limits: true
    max_acceleration: 7.85
  joint2_elbow:
    has_velocity_limits: true
    max_velocity: 62.8
    has_acceleration_limits: true
    max_acceleration: 7.85
  joint3_index_finger:
    has_velocity_limits: true
    max_velocity: 62.8
    has_acceleration_limits: true
    max_acceleration: 7.85
  joint4_middle_finger:
    has_velocity_limits: true
    max_velocity: 62.8
    has_acceleration_limits: true
    max_acceleration: 7.85
