cxxx1828/ROS1-Robot-Car-and-Robot-Arm/SW/Driver/motor_ctrl/include/motor_ctrl_pwm_map.h

#ifndef MOTOR_CLTR_PWM_MAP_H
#define MOTOR_CLTR_PWM_MAP_H

// For uint8_t.
#ifdef __KERNEL__
#include <linux/types.h>
#else
#include <stdint.h>
#endif


#define N_PWM_MAP 3
#define N_PWM_CH 6
#define N_PWM_SHARE 2

typedef enum {NONE, HW, SW} pwm_type_t;
typedef struct {
	pwm_type_t type;
	uint8_t ch;
} pwm_map_elem_t;

static const pwm_map_elem_t pwm_map[N_PWM_MAP][N_PWM_CH][N_PWM_SHARE] = {
	//[0]
	// To run both chassis and arm.
	// HW0 HW1 SW0 SW1 SW2 SW3
	{
		{{HW, 0}},
		{{HW, 1}},
		{{SW, 0}},
		{{SW, 1}},
		{{SW, 2}},
		{{SW, 3}}
	},
	
	//[1]
	// To run both chassis and arm, but more sever Parkinson.
	// SW0 SW1 SW2 SW3 HW0 HW1
	{
		{{SW, 0}},
		{{SW, 1}},
		{{SW, 2}},
		{{SW, 3}},
		{{HW, 0}},
		{{HW, 1}}
	},
	
	//[2]
	// More robust, but cannot run both chassis and arm.
	// HW0&SW0 HW1&SW1 SW2 SW3
	{
		{{HW, 0}, {SW, 0}},
		{{HW, 1}, {SW, 1}},
		{{SW, 2}},
		{{SW, 3}}
	}
};


#define ACTIVE_PWM_MAP 2


#endif // MOTOR_CLTR_PWM_MAP_H
